claudinoac/ElectricKettle/Fabrication_Files/PDF/Schematic.pdf

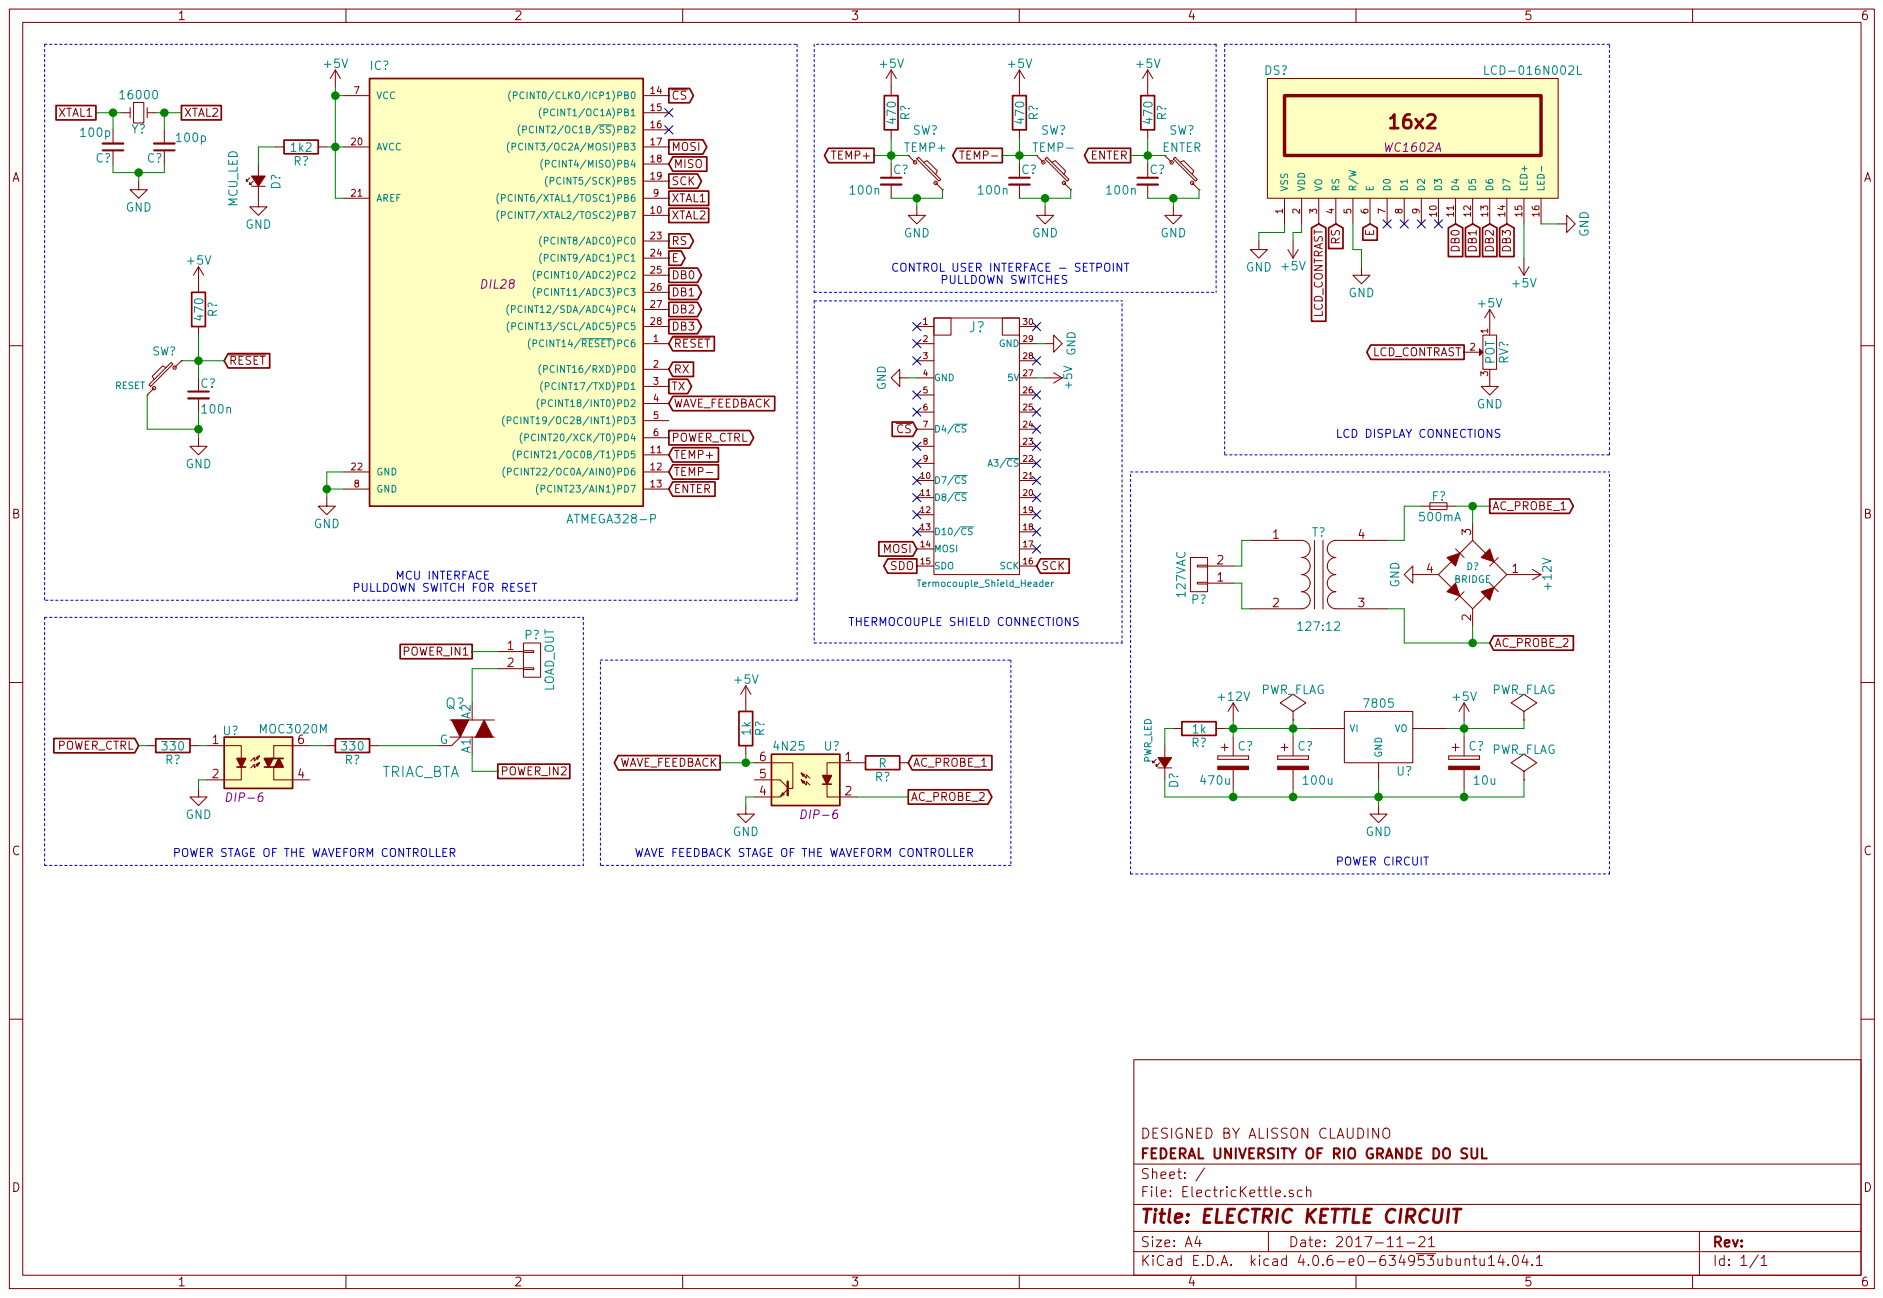
[picture p16: page 1]

LCD_CONTRAST RS SW? TEMP+ GND 470 R? +5V

9 D3 10 D4 11 D5 12 D6 13 D7 14 LED+ 15 LED- 16 DS? LCD-016N002L WC1602A GND +5V

LCD DISPLAY CONNECTIONS CONTROL USER INTERFACE - SETPOINT
PULLDOWN SWITCHES

File: ElectricKettle.sch Sheet: / FEDERAL UNIVERSITY OF RIO GRANDE DO SUL DESIGNED BY ALISSON CLAUDINO

Id: 1/1 Title: ELECTRIC KETTLE CIRCUIT
