claudinoac/ElectricKettle/Fabrication_Files/PDF/Bottom_Copper.pdf

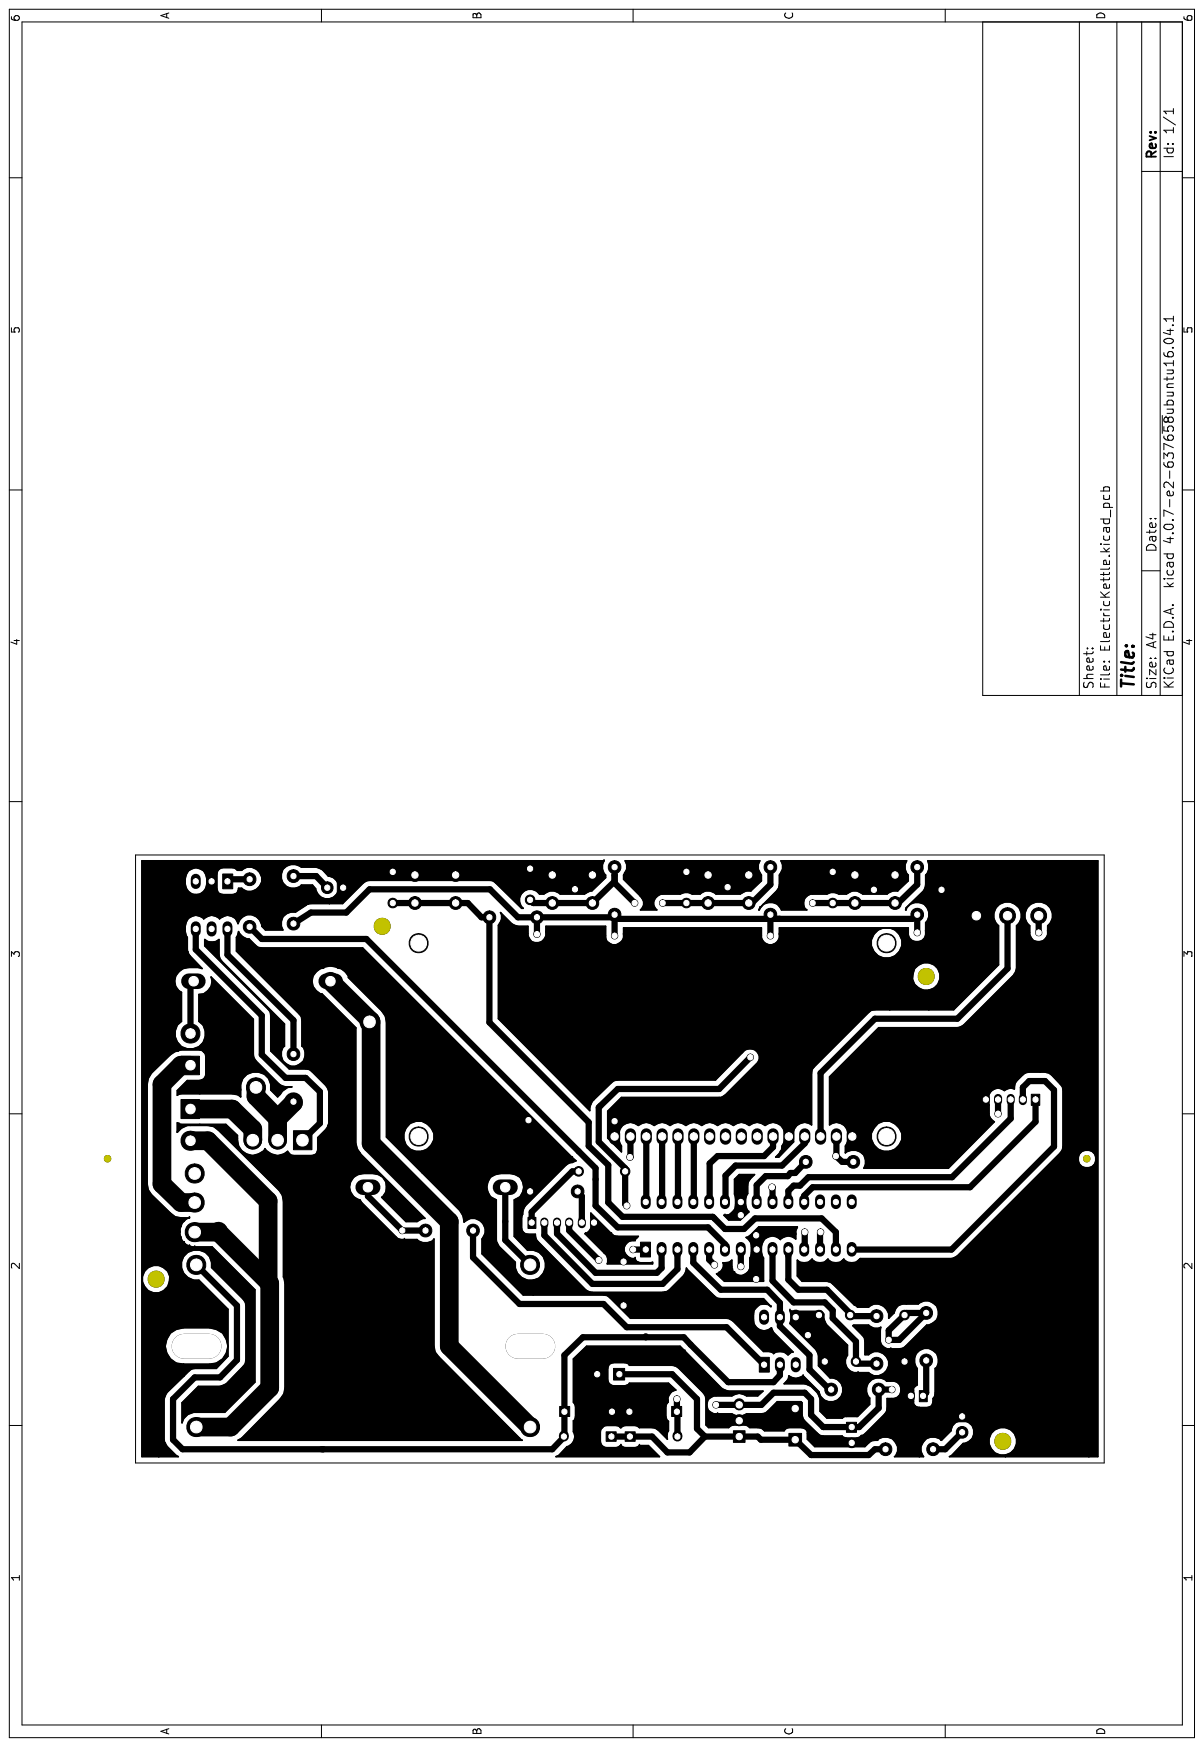
[picture p17: page 1]
