claudinoac/ElectricKettle/Fabrication_Files/PDF/Silkscreen.pdf

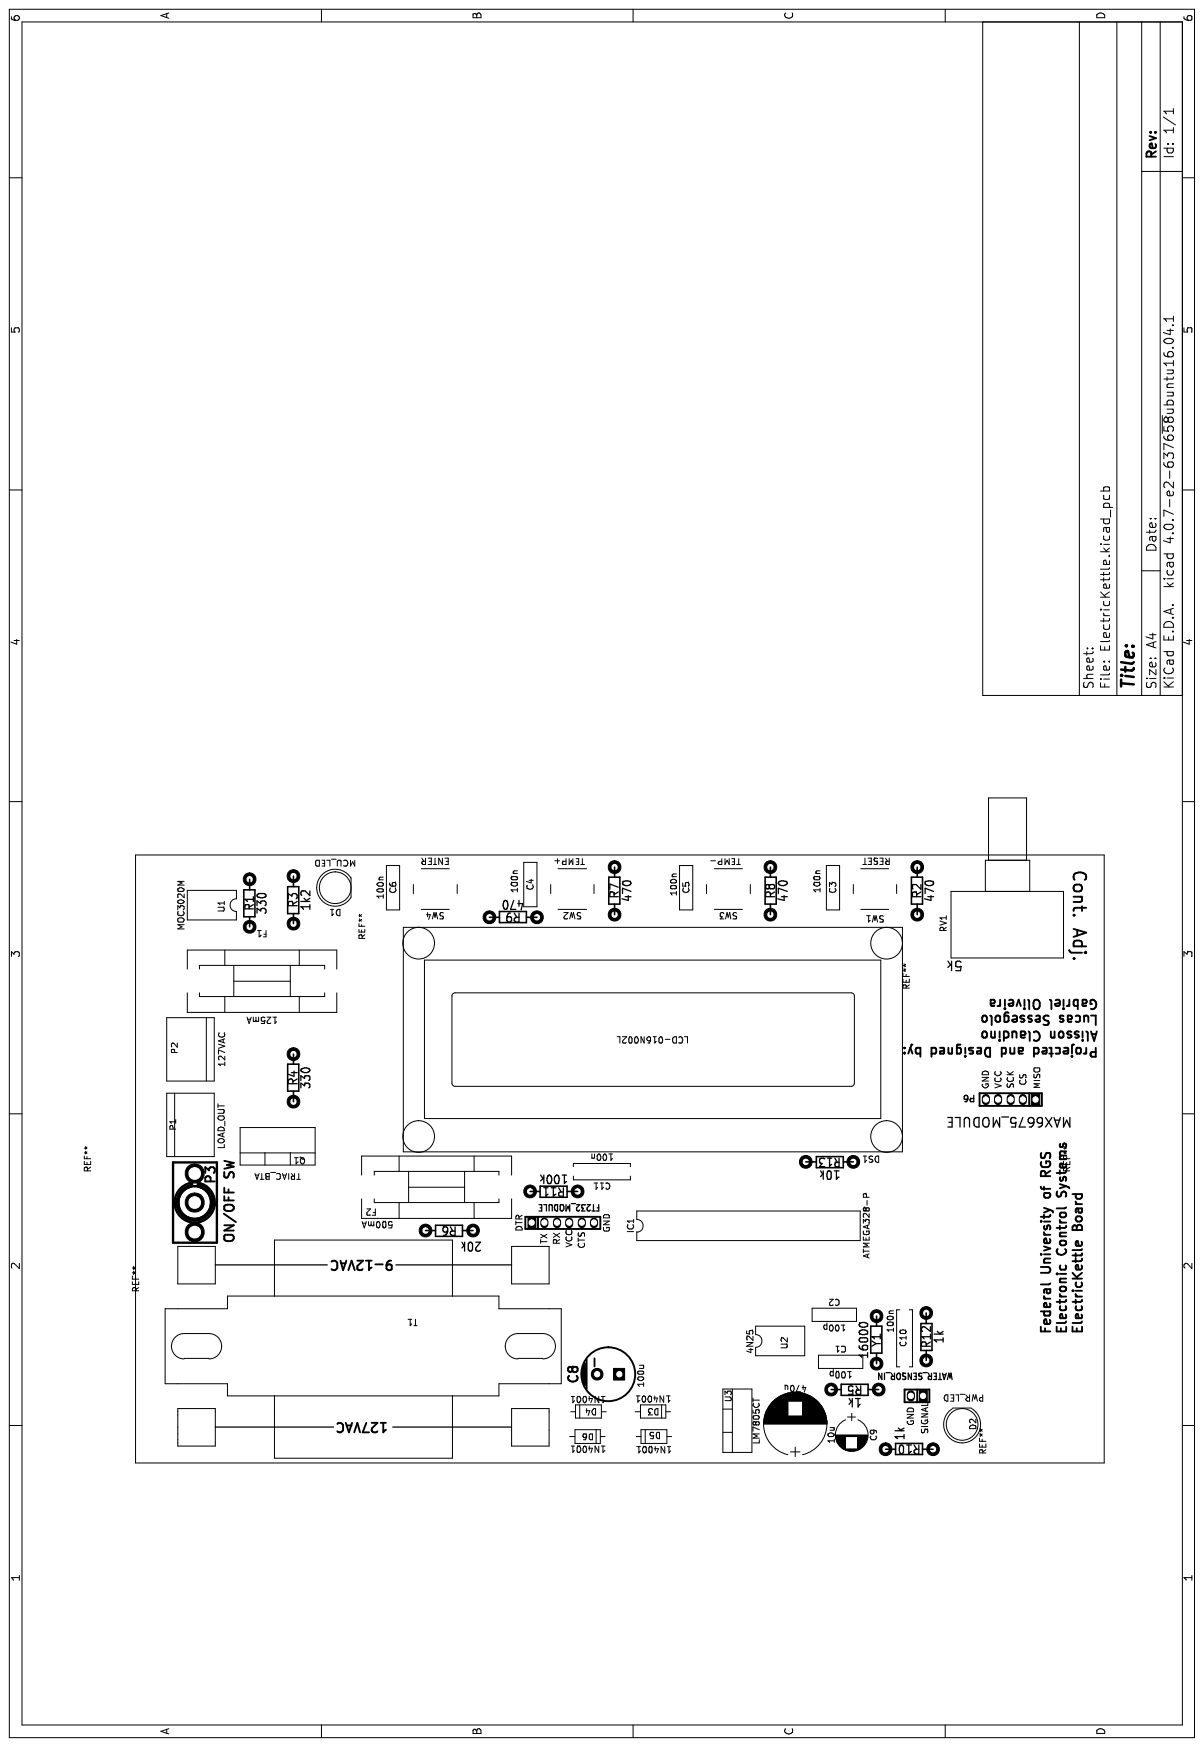
[picture p18: page 1]
