claudinoac/ElectricKettle/Fabrication_Files/PDF/Top_Copper.pdf

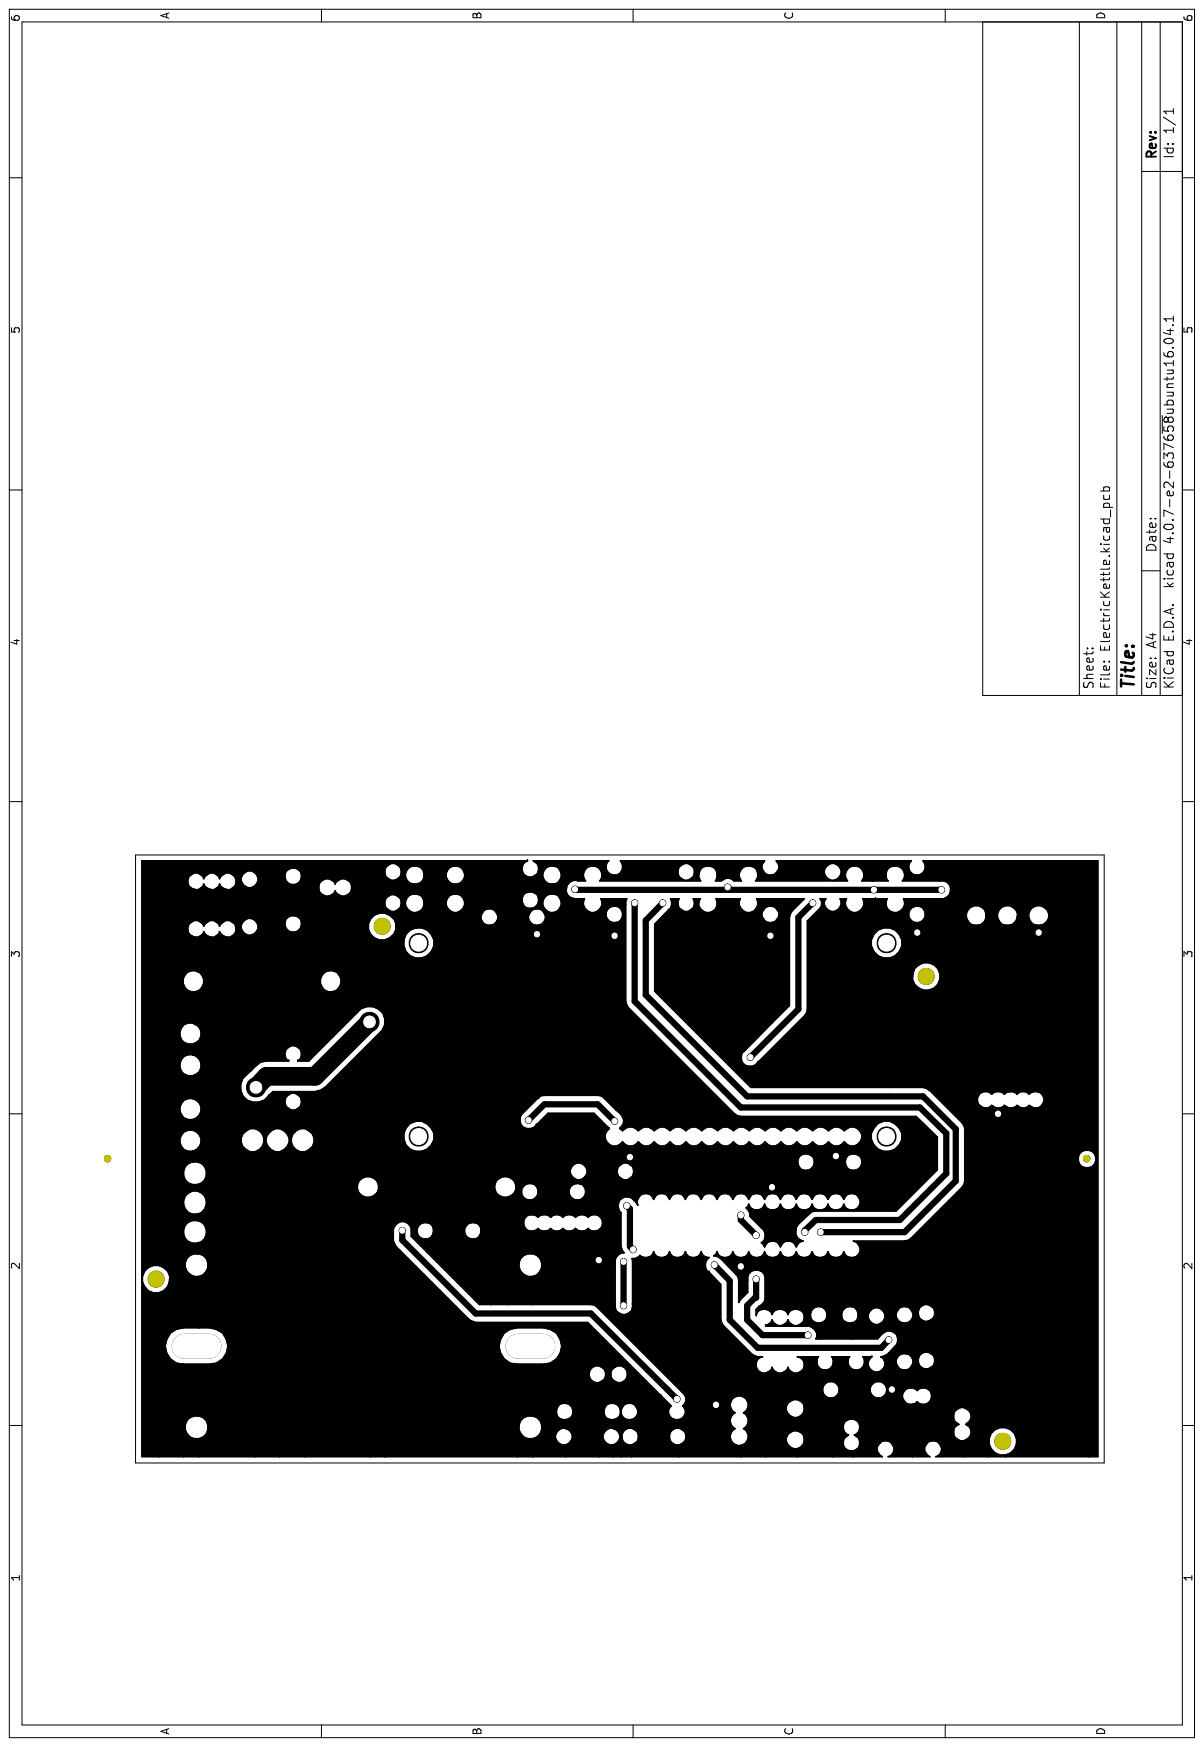
[picture p19: page 1]
