claudinoac/ElectricKettle/Fabrication_Files/KiCad_Files/ElectricKettle.kicad_pcb

## KiCad design Fabrication_Files/KiCad_Files/ElectricKettle.kicad_pcb (2018-02-07)

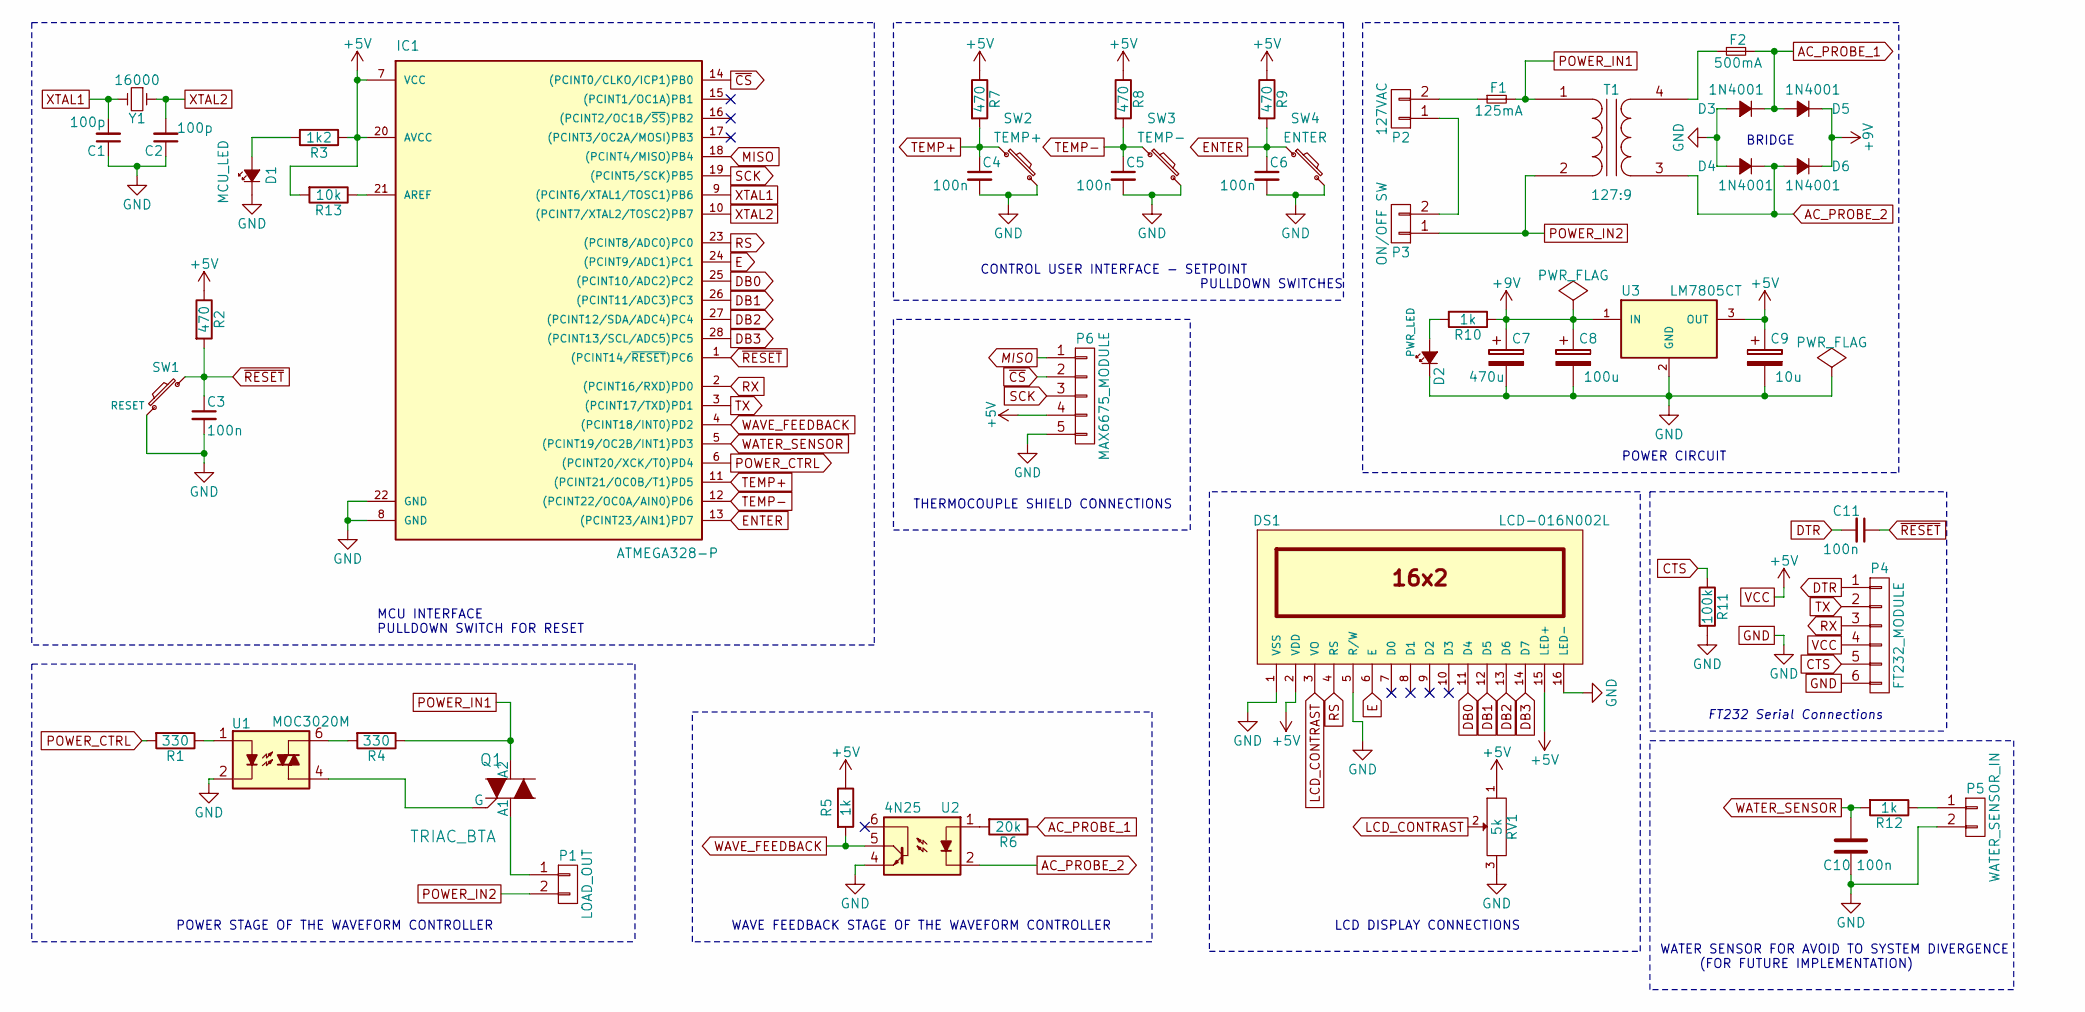
[picture p20: schematic ElectricKettle.sch, ELECTRIC KETTLE CIRCUIT]

Parts:
C1, C2: 100p; C_Rect_L7.0mm_W2.0mm_P5.00mm
C3, C4, C5, C6, C10, C11: 100n; C_Rect_L7.0mm_W2.0mm_P5.00mm
C7: 470u; CP_Radial_D10.0mm_P5.00mm
C8: 100u; C_Rect_L7.0mm_W2.0mm_P5.00mm
C9: 10u; CP_Radial_D5.0mm_P2.50mm
D1: MCU_LED; LED_D5.0mm
D2: PWR_LED; LED_D5.0mm
D3, D4, D5, D6: 1N4001; D_DO-35_SOD27_P7.62mm_Horizontal
DS1: LCD-016N002L; WC1602A
F1: 125mA; Fuseholder5x20_horiz_SemiClosed_Casing10x25mm
F2: 500mA; Fuseholder5x20_horiz_SemiClosed_Casing10x25mm
IC1: ATMEGA328-P; DIP-28_W7.62mm_LongPads
P1: LOAD_OUT; bornier2
P2: 127VAC; bornier2
P3: ON/OFF SW; bornier2
P4: FT232_MODULE; Pin_Header_Straight_1x06_Pitch1.27mm
P5: WATER_SENSOR_IN; Pin_Header_Straight_1x02_Pitch1.27mm
P6: MAX6675_MODULE; Pin_Header_Straight_1x05_Pitch1.27mm
Q1: TRIAC_BTA; TO-220_Vertical
R1, R4: 330; RC03
R2, R7, R8, R9: 470; RC03
R3: 1k2; RC03
R5, R10, R12: 1k; RC03
R6: 20k; RC03
R11: 100k; RC03
R13: 10k; RC03
RV1: 5k; Potentiometer_Alps_RK163_Single_Vertical
SW1: RESET; SW_PUSH_6mm
SW2: TEMP+; SW_PUSH_6mm
SW3: TEMP-; SW_PUSH_6mm
SW4: ENTER; SW_PUSH_6mm
T1: 127:9; 9V_transformer
U1: MOC3020M; DIP-6_W7.62mm_LongPads
U2: 4N25; DIP-6_W7.62mm_LongPads
U3: LM7805CT; TO-220_Vertical
Y1: 16000; RC03

Connections:
+9V: C7.1, C8.1, D5.1 (K), D6.1 (K), R10.1, U3.1 (IN)
AC_PROBE_1: D3.1 (K), D5.2 (A), F2.2, R6.1
AC_PROBE_2: D4.1 (K), D6.2 (A), T1.3 (SA), U2.2
CTS: P4.5, R11.1
DB0: DS1.11 (D4), IC1.25 ((PCINT10/ADC2)PC2)
DB1: DS1.12 (D5), IC1.26 ((PCINT11/ADC3)PC3)
DB2: DS1.13 (D6), IC1.27 ((PCINT12/SDA/ADC4)PC4)
DB3: DS1.14 (D7), IC1.28 ((PCINT13/SCL/ADC5)PC5)
DTR: C11.2, P4.1
E: DS1.6 (E), IC1.24 ((PCINT9/ADC1)PC1)
ENTER: C6.1, IC1.13 ((PCINT23/AIN1)PD7), R9.2, SW4.1
GND: C1.1, C2.1, C3.2, C4.2, C5.2, C6.2, C7.2, C8.2, C9.2, C10.2, D1.1 (K), D2.1 (K), D3.2 (A), D4.2 (A), DS1.1 (VSS), DS1.5 (R/W), DS1.16 (LED-), IC1.8 (GND), IC1.22 (GND), P4.6, P5.2, P6.5, R11.2, RV1.3, SW1.1, SW2.2, SW3.2, SW4.2, U1.2, U2.4, U3.2 (GND)
LCD_CONTRAST: DS1.3 (VO), RV1.2
MISO: IC1.18 ((PCINT4/MISO)PB4), P6.1
unnamed: D1.2 (A), R3.2
unnamed: D2.2 (A), R10.2
unnamed: F1.1, P2.2
unnamed: F2.1, T1.4 (SB)
unnamed: IC1.21 (AREF), R13.1
unnamed: P1.1, Q1.3 (A1)
unnamed: P2.1, P3.2
unnamed: P5.1, R12.1
unnamed: Q1.1 (G), U1.4
unnamed: R1.1, U1.1
unnamed: R4.2, U1.6
unnamed: R6.2, U2.1
POWER_CTRL: IC1.6 ((PCINT20/XCK/T0)PD4), R1.2
POWER_IN1: F1.2, Q1.2 (A2), R4.1, T1.1 (AA)
POWER_IN2: P1.2, P3.1, T1.2 (AB)
RS: DS1.4 (RS), IC1.23 ((PCINT8/ADC0)PC0)
RX: IC1.2 ((PCINT16/RXD)PD0), P4.3
SCK: IC1.19 ((PCINT5/SCK)PB5), P6.3
TEMP+: C4.1, IC1.11 ((PCINT21/OC0B/T1)PD5), R7.2, SW2.1
TEMP-: C5.1, IC1.12 ((PCINT22/OC0A/AIN0)PD6), R8.2, SW3.1
TX: IC1.3 ((PCINT17/TXD)PD1), P4.2
VCC: C9.1, DS1.2 (VDD), DS1.15 (LED+), IC1.7 (VCC), IC1.20 (AVCC), P4.4, P6.4, R2.1, R3.1, R5.1, R7.1, R8.1, R9.1, R13.2, RV1.1, U3.3 (OUT)
WATER_SENSOR: C10.1, IC1.5 ((PCINT19/OC2B/INT1)PD3), R12.2
WAVE_FEEDBACK: IC1.4 ((PCINT18/INT0)PD2), R5.2, U2.5
XTAL1: C1.2, IC1.9 ((PCINT6/XTAL1/TOSC1)PB6), Y1.2
XTAL2: C2.2, IC1.10 ((PCINT7/XTAL2/TOSC2)PB7), Y1.1
~CS: IC1.14 ((PCINT0/CLKO/ICP1)PB0), P6.2
~RESET: C3.1, C11.1, IC1.1 ((PCINT14/~RESET~)PC6), R2.2, SW1.2

Notes on the sheet:
POWER STAGE OF THE WAVEFORM CONTROLLER
WAVE FEEDBACK STAGE OF THE WAVEFORM CONTROLLER
LCD DISPLAY CONNECTIONS
CONTROL USER INTERFACE - SETPOINT PULLDOWN SWITCHES
MCU INTERFACE PULLDOWN SWITCH FOR RESET
POWER CIRCUIT
THERMOCOUPLE SHIELD CONNECTIONS
WATER SENSOR FOR AVOID TO SYSTEM DIVERGENCE (FOR FUTURE IMPLEMENTATION)
FT232 Serial Connections
BRIDGE

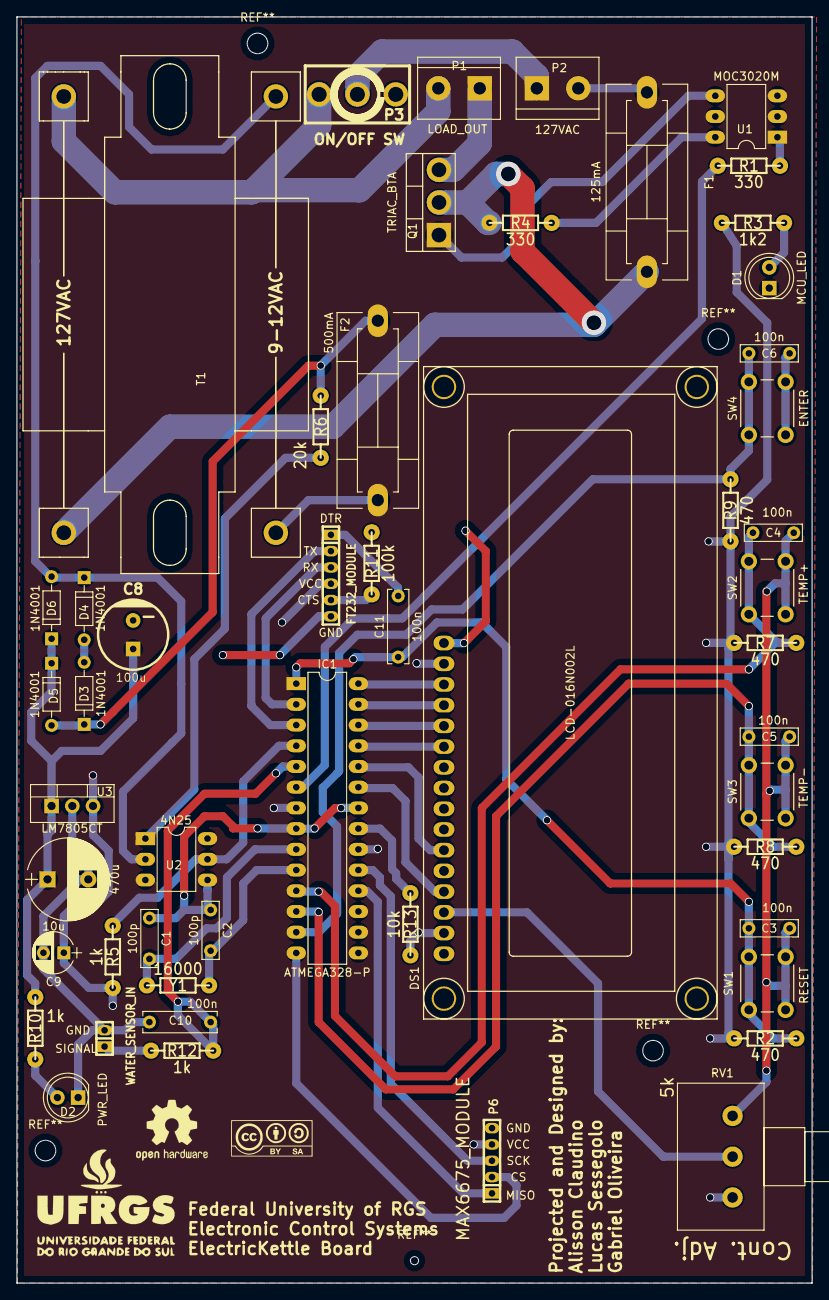
[picture p21: board ElectricKettle.kicad_pcb from above]

Board: 2 copper layers, 97.5 x 155.2 mm, 51 parts (0 on the bottom side), 42 nets.
