claudinoac/ElectricKettle/(commit log)

2017-11-20 First Commit: Added partial circuit schematic
    [ElectricKettle.kicad_pcb, ElectricKettle.sch]
2017-11-21 Complete Schematic V0.1
    [ElectricKettle.sch]
2017-11-23 ADD: Water Sensor Filter and Socket for Future Implementation
2018-02-07 ADD: All Fabrication Files
    [ElectricKettle.kicad_pcb, ElectricKettle.sch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]
2018-02-07 EDIT: Folder Organization
    [ElectricKettle.kicad_pcb, ElectricKettle.sch]
